HexabitzPlatform/H14RAx-Hardware/README.md

# H14RAx-Hardware
Hexabitz 6 x 5V PWM O/P Module Hardware Design
