HexabitzPlatform/H14RAx-Hardware/Documentation/H14RA Schematics.pdf

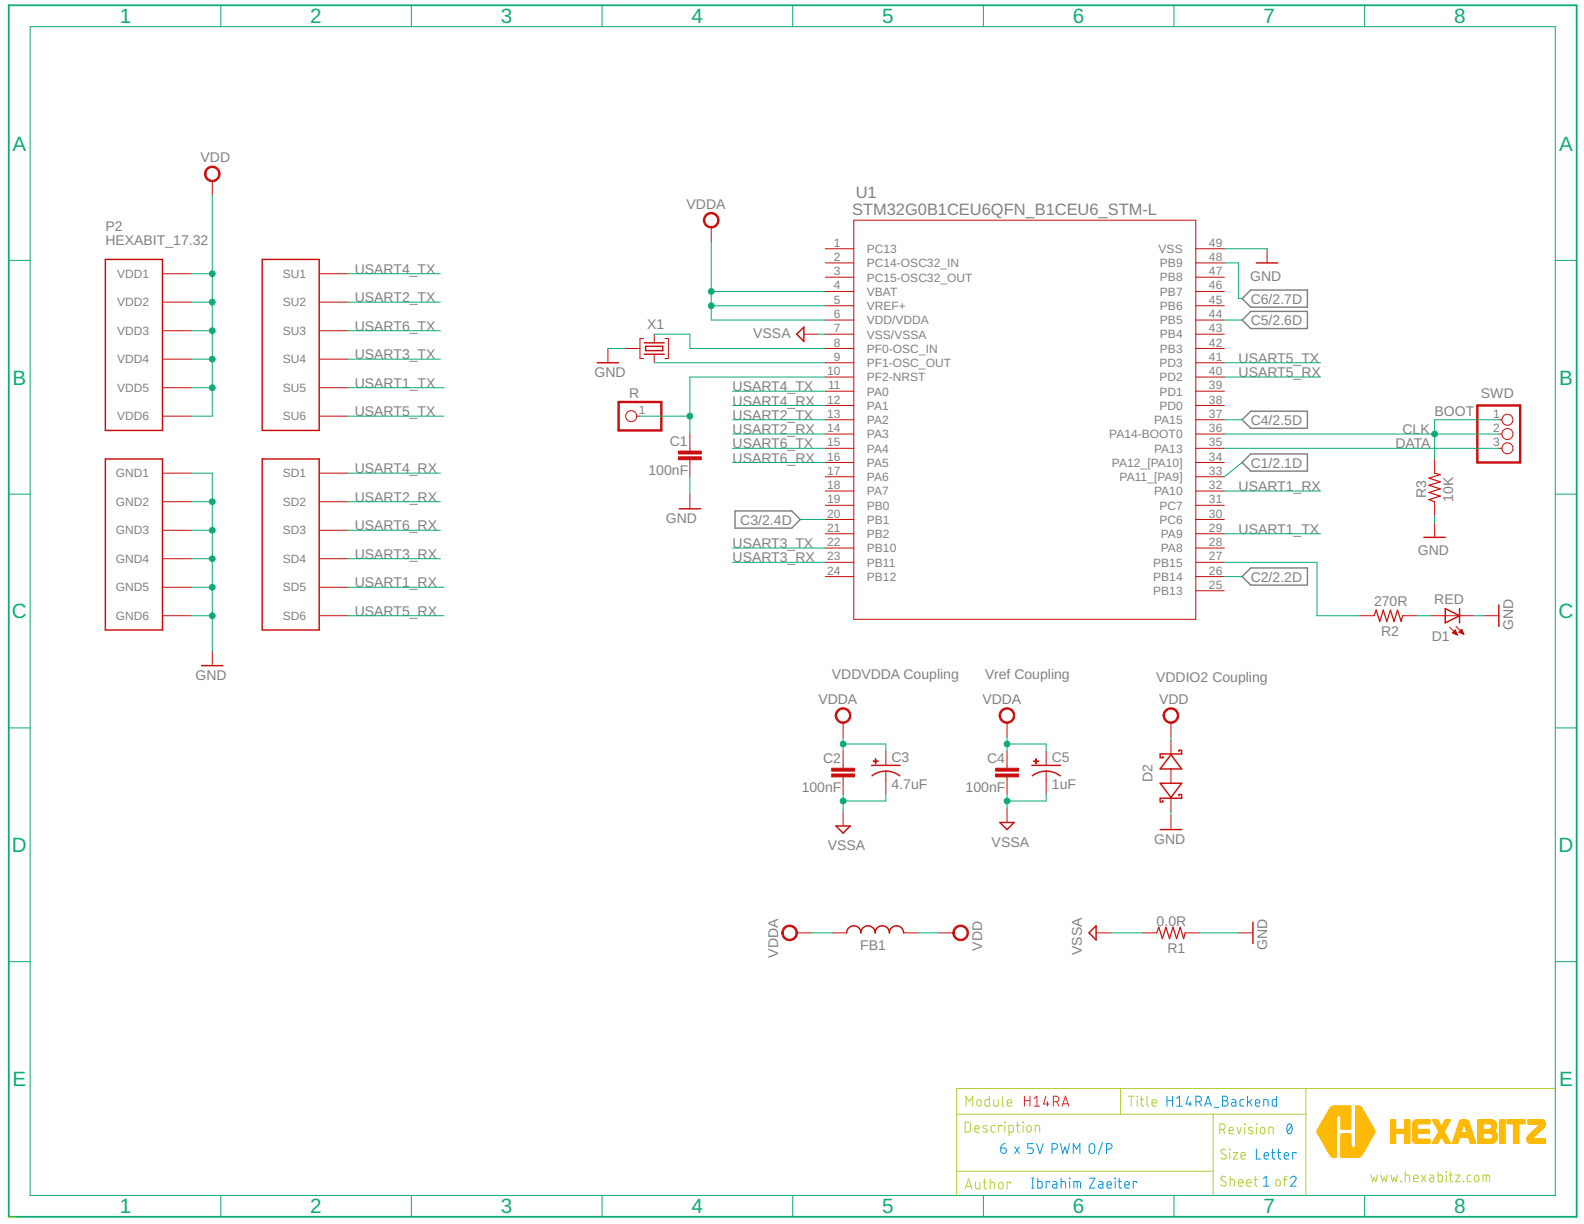
[picture p1: page 1]

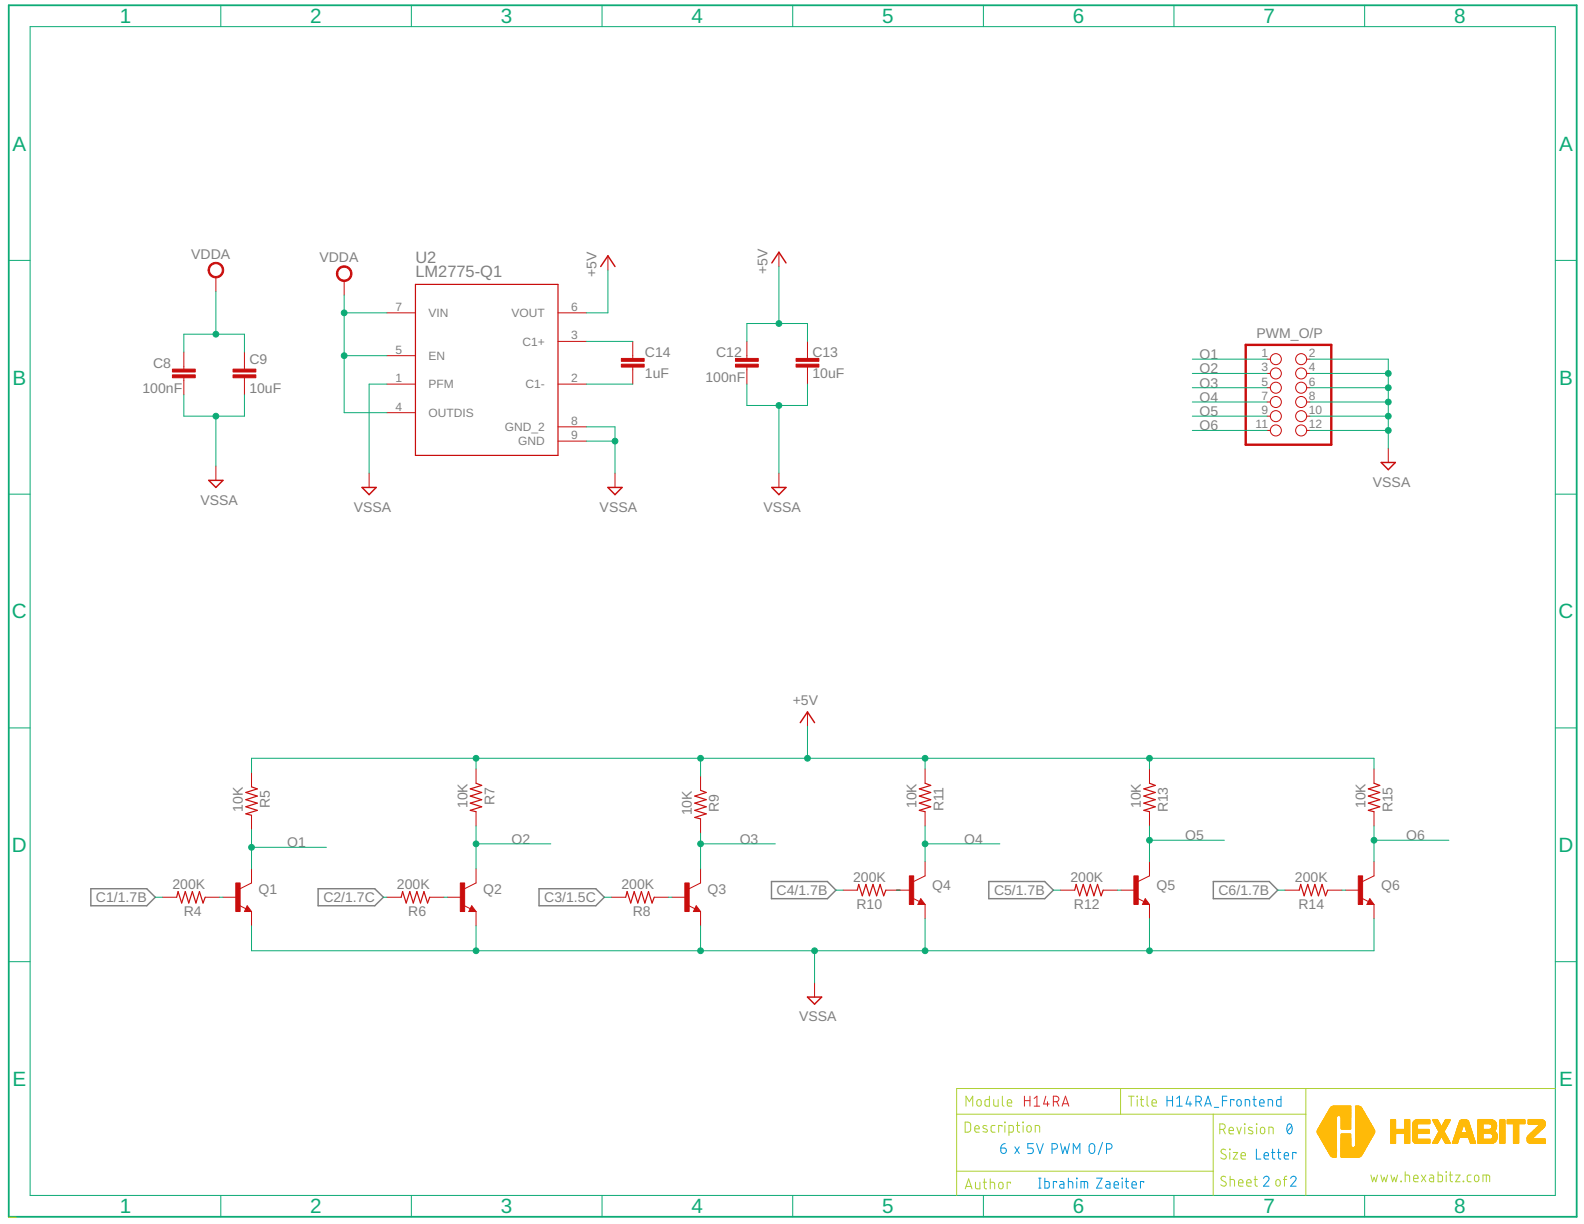
[picture p2: page 2]
