HexabitzPlatform/H14RAx-Hardware/(commit log)

2023-09-16 -First Version
    [H14RA0.brd, H14RA0.sch, H14RA0.xlsx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]
2023-11-16 -Correcting some documentaion isses
    [H14RA0.xlsx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]
2024-12-26 -Fix the issue with an MCU pin that cannot output PWM signals. -Update the design and BOM to reflect the latest modifications in the Platform Hardware rules.
    [H14RA.brd, H14RA.sch, H14RA.xlsx, H14RA0.sch, H14RA0.xlsx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]
