HexabitzPlatform/H14RAx-Hardware/(notices)

Notices in the files:
parts and their libraries:
COPYRIGHT: Copyright (C) 2021 Ultra Librarian. All rights reserved.
